bella7898/SL_ADC_DE10Lite/650PM.step

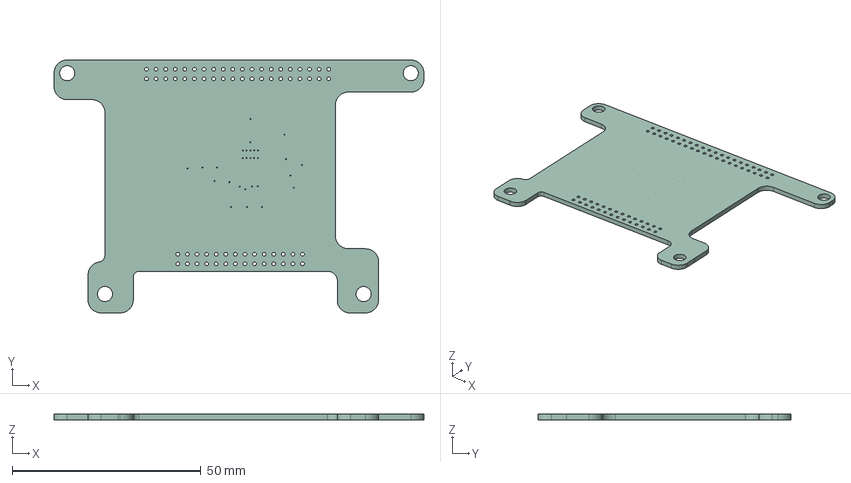
[picture p1: CAD file, 2026-08-02]
650PM.step
98.0 x 67.0 x 1.51 mm
