bella7898/SL_ADC_DE10Lite/SL_ADC_DE10lite_V2.step

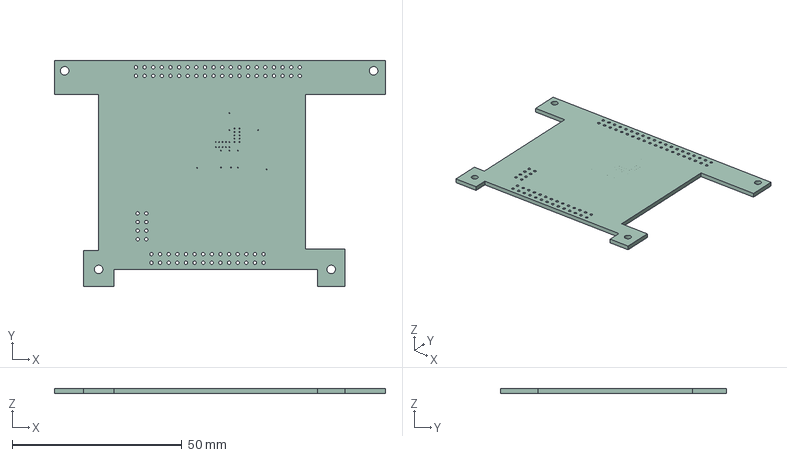
[picture p2: CAD file, 2026-07-04]
SL_ADC_DE10lite_V2.step
97.5 x 66.5 x 1.51 mm
