bella7898/SL_ADC_DE10Lite/(list of files, cad)

Other CAD files:
tmp/current-outline-test.step
