bella7898/SL_ADC_DE10Lite/SL_ADC_DE10Lite.kicad_pcb

## KiCad design SL_ADC_DE10Lite.kicad_pcb (2026-08-02)

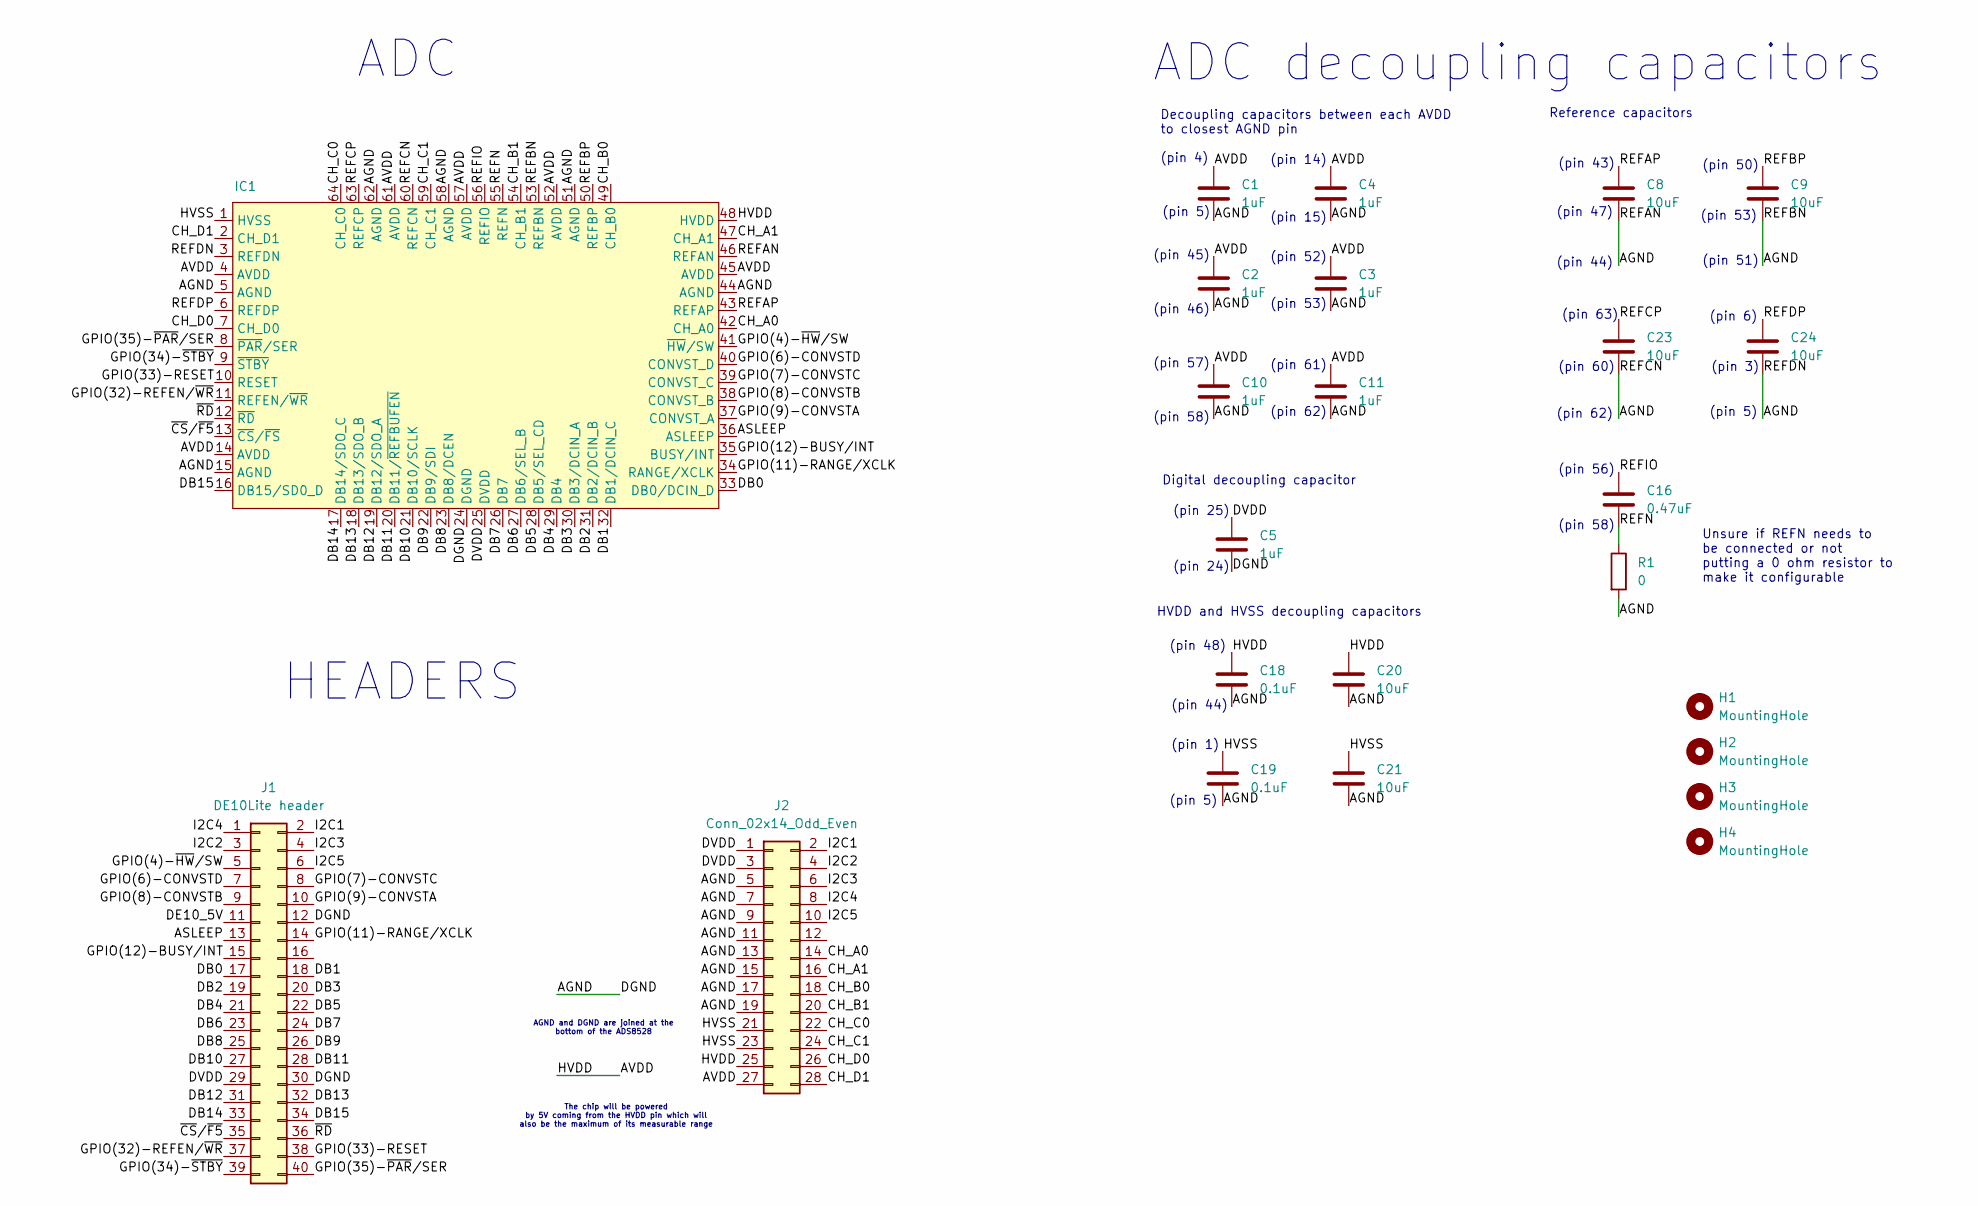
[picture p3: schematic SL_ADC_DE10Lite.kicad_sch]

Parts:
C1, C2, C3, C4, C5, C10, C11: 1uF; C_0805_2012Metric_Pad1.18x1.45mm_HandSolder; Manufacturer_Part_Number CL21B105KBFNNNE
C8, C9, C20, C21, C23, C24: 10uF; C_0805_2012Metric_Pad1.18x1.45mm_HandSolder; Manufacturer_Part_Number CL21B106KOQNNNE
C16: 0.47uF; C_0805_2012Metric_Pad1.18x1.45mm_HandSolder; Manufacturer_Part_Number CL21B106KOQNNNE
C18, C19: 0.1uF; C_0805_2012Metric_Pad1.18x1.45mm_HandSolder; Manufacturer_Part_Number CL21B106KOQNNNE
H1, H2, H3, H4: MountingHole; MountingHole_2.5mm
IC1: TQFP-64_10x10mm_P0.5mm
J1: DE10Lite header; PinHeader_2x20_P2.54mm_Vertical
J2: Conn_02x14_Odd_Even; PinHeader_2x14_P2.54mm_Vertical
R1: 0; LED_0805_2012Metric

Connections:
/AGND: C1.2, C2.2, C3.2, C4.2, C5.2, C8.2, C9.2, C10.2, C11.2, C18.2, C19.2, C20.2, C21.2, C23.2, C24.2, IC1.3 (REFDN), IC1.5 (AGND), IC1.15 (AGND), IC1.24 (DGND), IC1.44 (AGND), IC1.46 (REFAN), IC1.51 (AGND), IC1.53 (REFBN), IC1.58 (AGND), IC1.60 (REFCN), IC1.62 (AGND), J1.12, J1.30, J2.5, J2.7, J2.9, J2.11, J2.13, J2.15, J2.17, J2.19, R1.2
/ASLEEP: IC1.36 (ASLEEP), J1.13
/AVDD: C1.1, C2.1, C3.1, C4.1, C10.1, C11.1, C18.1, C20.1, IC1.4 (AVDD), IC1.14 (AVDD), IC1.45 (AVDD), IC1.48 (HVDD), IC1.52 (AVDD), IC1.57 (AVDD), IC1.61 (AVDD), J2.25, J2.27
/CH_A0: IC1.42 (CH_A0), J2.14
/CH_A1: IC1.47 (CH_A1), J2.16
/CH_B0: IC1.49 (CH_B0), J2.18
/CH_B1: IC1.54 (CH_B1), J2.20
/CH_C0: IC1.64 (CH_C0), J2.22
/CH_C1: IC1.59 (CH_C1), J2.24
/CH_D0: IC1.7 (CH_D0), J2.26
/CH_D1: IC1.2 (CH_D1), J2.28
/DB0: IC1.33 (DB0/DCIN_D), J1.17
/DB1: IC1.32 (DB1/DCIN_C), J1.18
/DB2: IC1.31 (DB2/DCIN_B), J1.19
/DB3: IC1.30 (DB3/DCIN_A), J1.20
/DB4: IC1.29 (DB4), J1.21
/DB5: IC1.28 (DB5/SEL_CD), J1.22
/DB6: IC1.27 (DB6/SEL_B), J1.23
/DB7: IC1.26 (DB7), J1.24
/DB8: IC1.23 (DB8/DCEN), J1.25
/DB9: IC1.22 (DB9/SDI), J1.26
/DB10: IC1.21 (DB10/SCLK), J1.27
/DB11: IC1.20 (DB11/~REFBUFEN), J1.28
/DB12: IC1.19 (DB12/SDO_A), J1.31
/DB13: IC1.18 (DB13/SDO_B), J1.32
/DB14: IC1.17 (DB14/SDO_C), J1.33
/DB15: IC1.16 (DB15/SD0_D), J1.34
/DE10_5V: J1.11
/DVDD: C5.1, IC1.25 (DVDD), J1.29, J2.1, J2.3
/GPIO(4)-~HW/SW: IC1.41 (~HW/SW), J1.5
/GPIO(6)-CONVSTD: IC1.40 (CONVST_D), J1.7
/GPIO(7)-CONVSTC: IC1.39 (CONVST_C), J1.8
/GPIO(8)-CONVSTB: IC1.38 (CONVST_B), J1.9
/GPIO(9)-CONVSTA: IC1.37 (CONVST_A), J1.10
/GPIO(11)-RANGE/XCLK: IC1.34 (RANGE/XCLK), J1.14
/GPIO(12)-BUSY/INT: IC1.35 (BUSY/INT), J1.15
/GPIO(32)-REFEN/~WR: IC1.11 (REFEN/~WR), J1.37
/GPIO(33)-RESET: IC1.10 (RESET), J1.38
/GPIO(34)-~STBY: IC1.9 (~STBY), J1.39
/GPIO(35)-~PAR/SER: IC1.8 (~PAR/SER), J1.40
/HVSS: C19.1, C21.1, IC1.1 (HVSS), J2.21, J2.23
/I2C1: J1.2, J2.2
/I2C2: J1.3, J2.4
/I2C3: J1.4, J2.6
/I2C4: J1.1, J2.8
/I2C5: J1.6, J2.10
/REFAP: C8.1, IC1.43 (REFAP)
/REFBP: C9.1, IC1.50 (REFBP)
/REFCP: C23.1, IC1.63 (REFCP)
/REFDP: C24.1, IC1.6 (REFDP)
/REFIO: C16.1, IC1.56 (REFIO)
/REFN: C16.2, IC1.55 (REFN), R1.1
/~CS/~F5: IC1.13 (~CS/~FS), J1.35
/~RD: IC1.12 (~RD), J1.36

Notes on the sheet:
(pin 14)
Digital decoupling capacitor
(pin 60)
AGND and DGND are joined at the bottom of the ADS8528
(pin 1)
HVDD and HVSS decoupling capacitors
(pin 4)
(pin 45)
ADC decoupling capacitors
Reference capacitors
(pin 62)
(pin 3)
(pin 15)
The chip will be powered by 5V coming from the HVDD pin which will also be the maximum of its measurable range
ADC
(pin 61)
(pin 50)
(pin 53)
(pin 47)
(pin 24)
Unsure if REFN needs to be connected or not putting a 0 ohm resistor to make it configurable
(pin 63)
(pin 43)
(pin 25)
(pin 51)
(pin 46)
(pin 57)
(pin 48)
(pin 5)
(pin 44)
(pin 58)
(pin 6)
Decoupling capacitors between each AVDD to closest AGND pin
(pin 56)
(pin 58)
(pin 52)
HEADERS

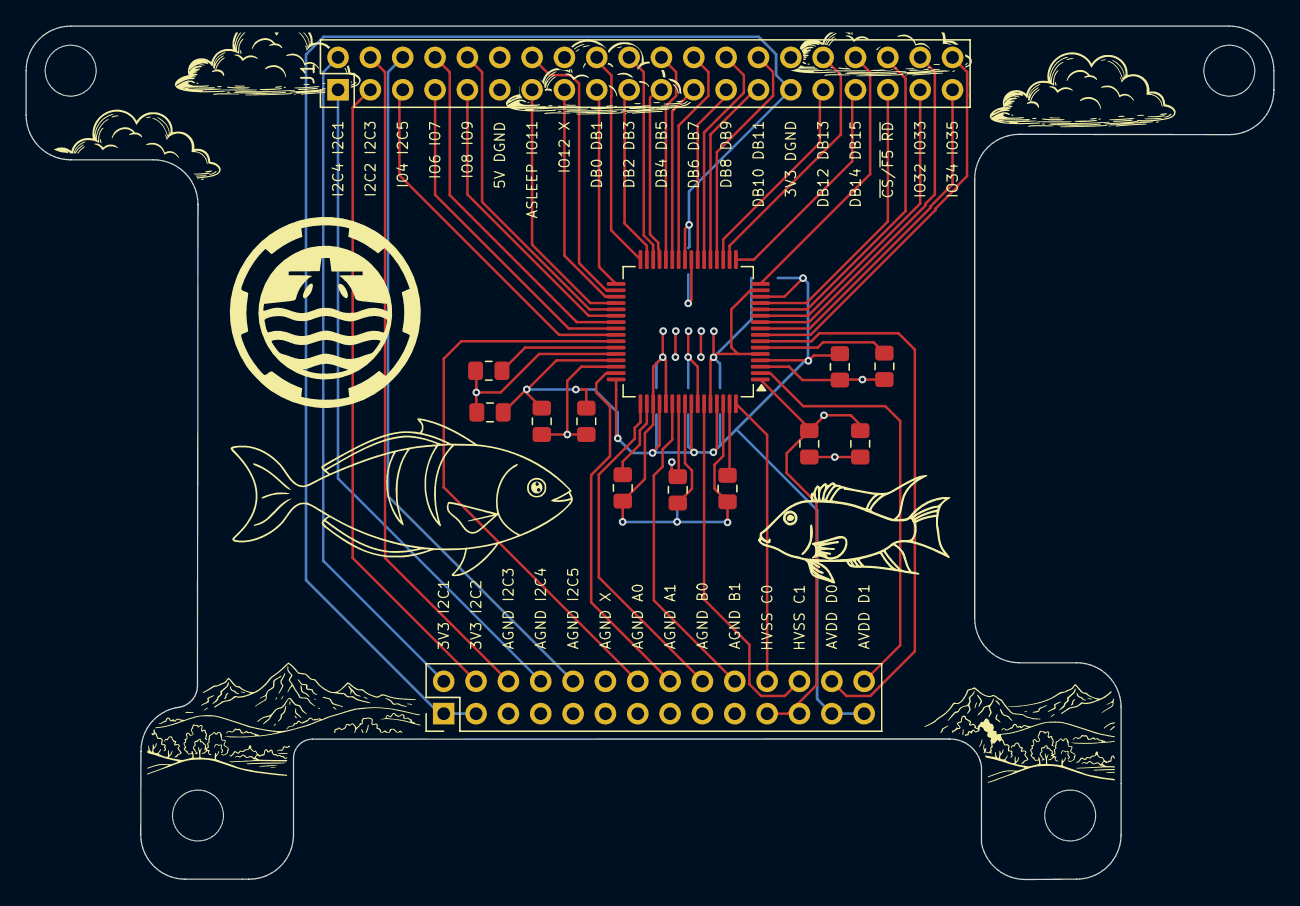
[picture p4: board SL_ADC_DE10Lite.kicad_pcb from above]

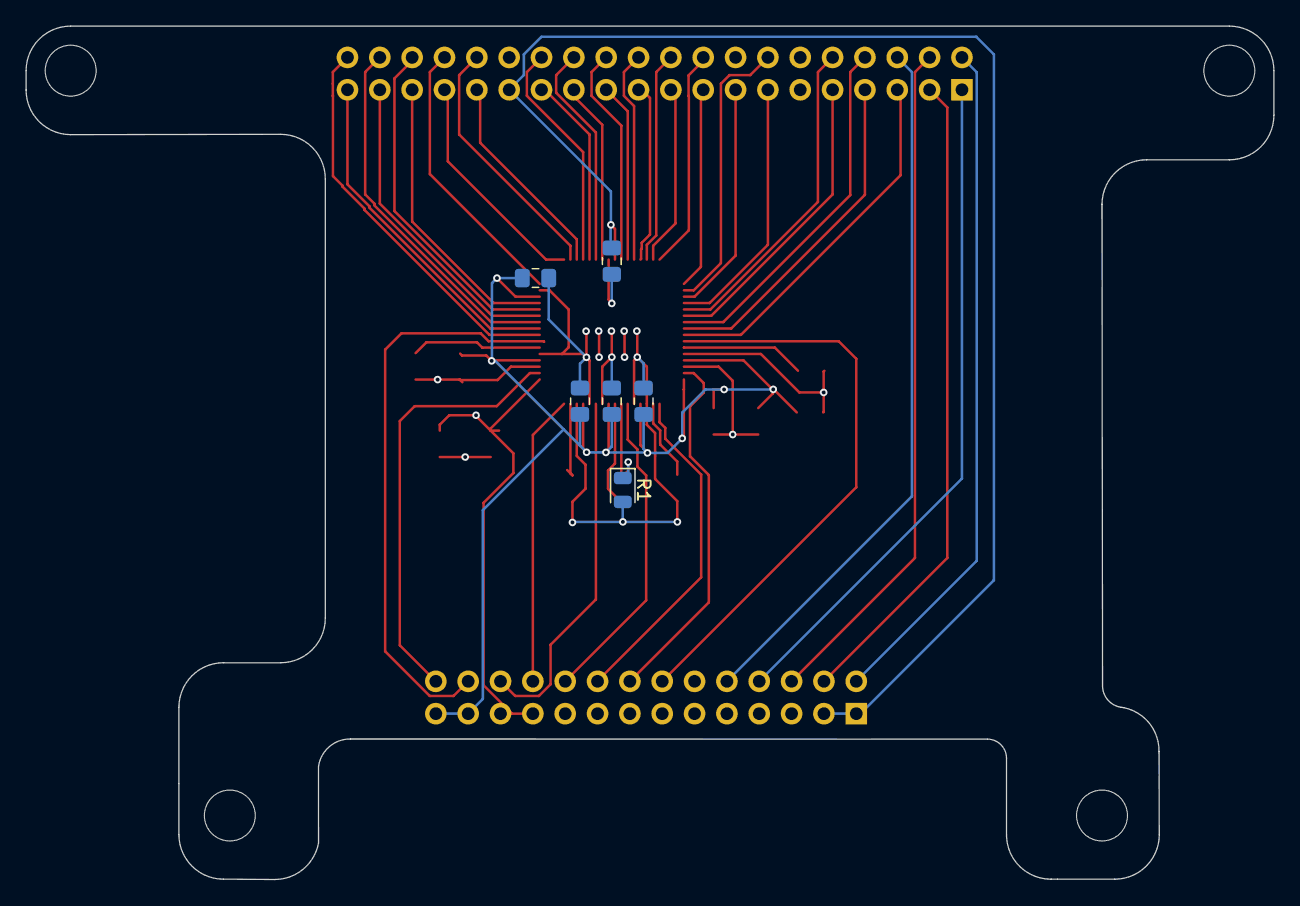
[picture p5: board SL_ADC_DE10Lite.kicad_pcb from below]

Board: 4 copper layers, 98.0 x 67.0 mm, 25 parts (6 on the bottom side), 53 nets.

Other parts of the board:
G: LOGO; SubbotsLogo
