bella7898/SL_ADC_DE10Lite/(commit log)

2026-05-15 Changes to decoupling capacitors
    [SL_ADC_DE10Lite.kicad_sch]
2026-05-30 Added inner copper layers and capacitor routes
    [SL_ADC_DE10Lite.kicad_pcb, SL_ADC_DE10Lite.kicad_sch]
2026-06-08 Update net names
    [SL_ADC_DE10Lite.kicad_pcb, SL_ADC_DE10Lite.kicad_sch]
2026-06-08 Add analog header
    [SL_ADC_DE10Lite.kicad_pcb, SL_ADC_DE10Lite.kicad_sch]
2026-06-12 left feedback for first run of work as comments and silkscreen labels. To be deleted
    [SL_ADC_DE10Lite.kicad_pcb]
2026-06-13 some commments
    [SL_ADC_DE10Lite.kicad_sch]
2026-06-15 Add De10lite dimensions and routes
    [SL_ADC_DE10Lite.kicad_pcb, SL_ADC_DE10Lite.kicad_sch]
2026-06-16 Define separate AGND and DGND copper fill
    [SL_ADC_DE10Lite.kicad_pcb, SL_ADC_DE10Lite.kicad_sch]
2026-06-27 Recent changes
    [SL_ADC_DE10Lite.kicad_pcb, SL_ADC_DE10Lite.kicad_sch]
2026-06-27 Updated version
    [SL_ADC_DE10Lite.kicad_pcb, SL_ADC_DE10Lite.kicad_sch]
2026-06-27 Rounded corners!!!
    [SL_ADC_DE10Lite.kicad_pcb, SL_ADC_DE10Lite.kicad_sch]
2026-06-27 Board outline error?
    [SL_ADC_DE10Lite.kicad_pcb]
2026-06-28 Generated step file
    [.step, SL_ADC_DE10Lite.kicad_pcb]
2026-07-04 widened standoff holes
    [SL_ADC_DE10Lite.kicad_pcb, SL_ADC_DE10Lite.kicad_sch, SL_ADC_DE10lite_V2.step]
2026-07-09 Add graphics!
    [SL_ADC_DE10Lite.kicad_pcb]
2026-07-09 added a few ground vias and fixed board outline error
    [.step, SL_ADC_DE10Lite.kicad_pcb]
2026-07-15 Add power trace
    [SL_ADC_DE10Lite.kicad_pcb]
2026-07-30 fixed some missing connections, more to go
    [SL_ADC_DE10Lite.kicad_pcb]
2026-07-30 set HVDD to AVDD to share power supply and also updated PCB doc from schematic, re-routing and connecting AVDD to power needed still
    [SL_ADC_DE10Lite.kicad_pcb, SL_ADC_DE10Lite.kicad_sch]
2026-07-30 updated PCB to match foodtprint header pinout, flagged issues with ground planes only being on one layer and not being under all the relevant pins. Re-routing and ground plane re-shaping needed
    [SL_ADC_DE10Lite.kicad_pcb, SL_ADC_DE10Lite.kicad_sch]
2026-08-01 Re routed, reshaped ground planes and included on both layers, next, add silkscreens
    [SL_ADC_DE10Lite.kicad_pcb]
2026-08-01 fixed some DRC issues
    [SL_ADC_DE10Lite.kicad_pcb, SL_ADC_DE10Lite.kicad_sch]
2026-08-01 renamed pin silkscreens
    [SL_ADC_DE10Lite.kicad_pcb]
2026-08-01 Clipped silkscreens around the edges of PCB
    [SL_ADC_DE10Lite.kicad_pcb]
2026-08-01 removed user 1 silkscreen cutoff polygon
    [SL_ADC_DE10Lite.kicad_pcb]
2026-08-01 added 0 ohm jumper for REFN and increase via to ADC spacing while decrasing cap to ADC spacing
    [SL_ADC_DE10Lite.kicad_sch]
2026-08-02 fixed DGND DVDD and 5V pin placements to match DE10 in real life
    [SL_ADC_DE10Lite.kicad_pcb]
2026-08-02 fixed header issue
    [SL_ADC_DE10Lite.kicad_pcb, SL_ADC_DE10Lite.kicad_sch]
2026-08-02 patch board outline issue
    [SL_ADC_DE10Lite.kicad_pcb]
2026-08-02 fixed board outline issue and silkscreen pad clearance issue on new header footprint
    [SL_ADC_DE10Lite.kicad_pcb, current-outline-test.step]
2026-08-02 fixed minor silkscreen issues
    [.step, 650PM.step, SL_ADC_DE10Lite.kicad_pcb]
2026-08-02 perfectly aligned the silkscreen labels
    [SL_ADC_DE10Lite.kicad_pcb]
2026-08-02 fixed up digital power pin silkscreens
    [SL_ADC_DE10Lite.kicad_pcb, SL_ADC_DE10Lite.kicad_sch]
